lu7did/Pixino/images/MaidenQSO.jpg

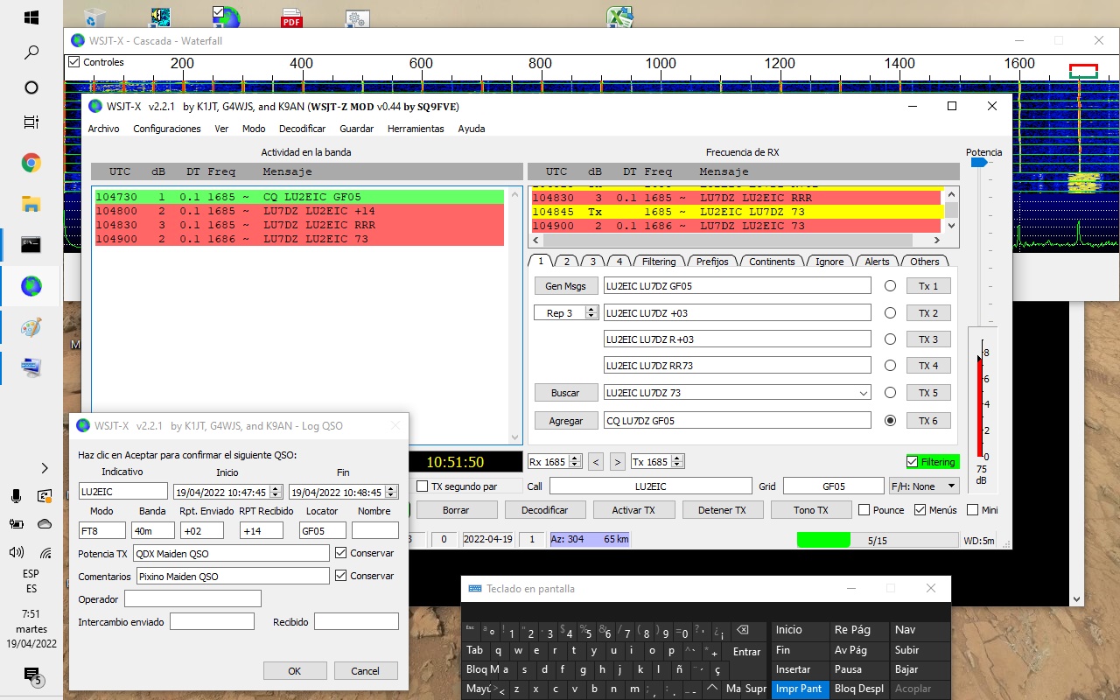
images/MaidenQSO.jpg
