lu7did/Pixino/images/pixino.bmp

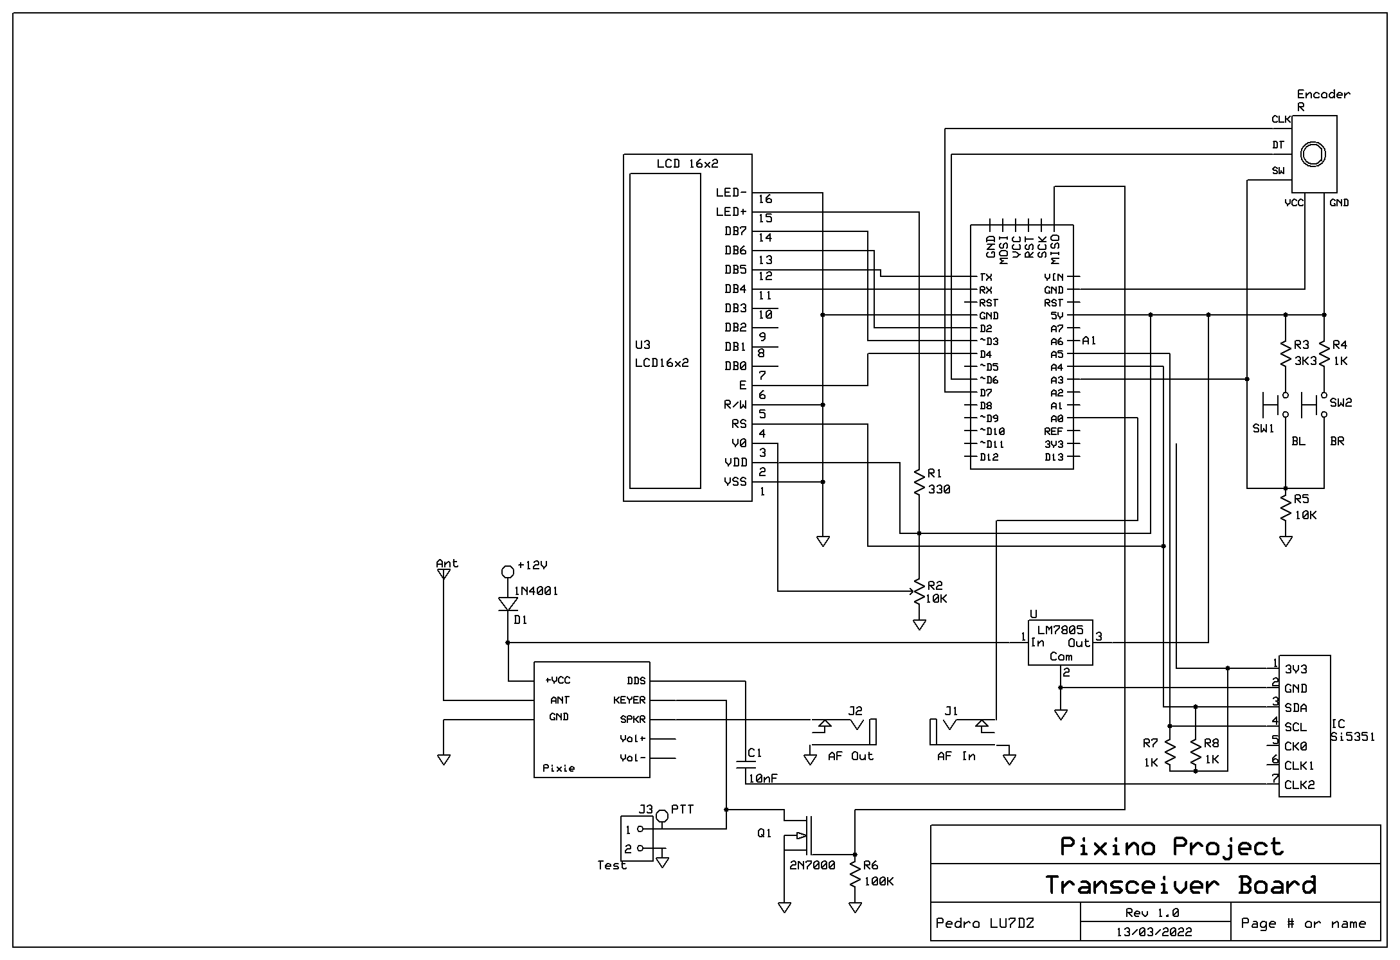
images/pixino.bmp
