lu7did/Pixino/(threads)

Thread 6 (2023-11-07):

Failed to compile

Roy449, 2023-11-07:
/usr/local/bin/arduino-cli compile --fqbn arduino:avr:uno --build-cache-path /tmp --output-dir /tmp/860181873/build --build-path /tmp/arduino-build-4A4465BBF6ACD24B22DF9C35161CDBD8 /tmp/860181873/Pixino

/tmp/860181873/Pixino/Pixino.ino:217:5: error: #error "Unsupported Arduino IDE version, use Arduino IDE 1.8.10 or later from https://www.arduino.cc/en/software"

#error "Unsupported Arduino IDE version, use Arduino IDE 1.8.10 or later from https://www.arduino.cc/en/software"

^~~~~

Error during build: exit status 1

Can you solve this problem?
